mirfatif/SolarBMS/docs/current_voltage_module.jpg

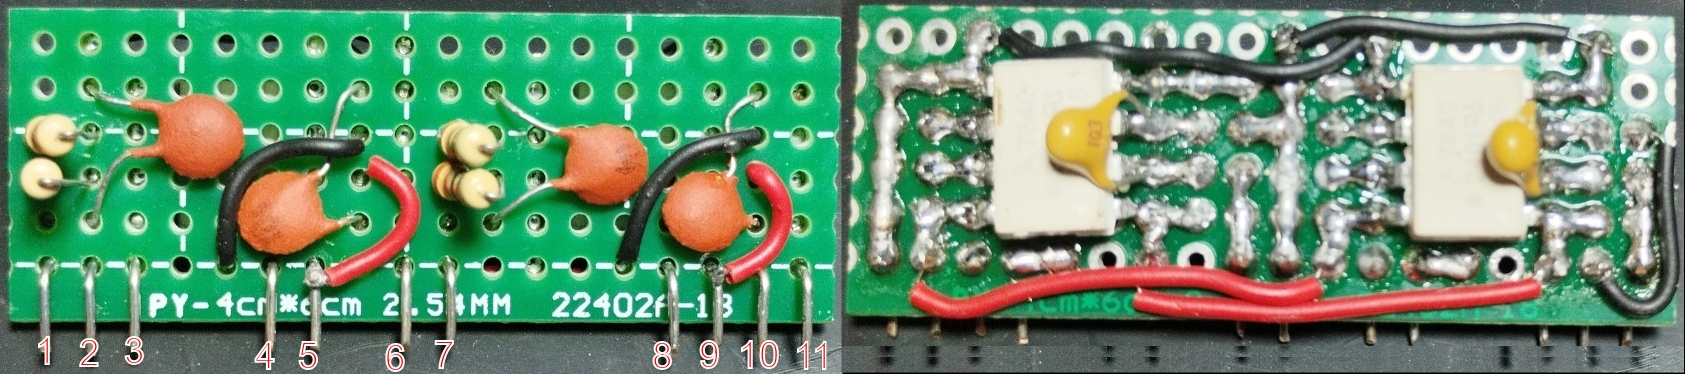
docs/current_voltage_module.jpg
