mirfatif/SolarBMS/docs/image.jpg

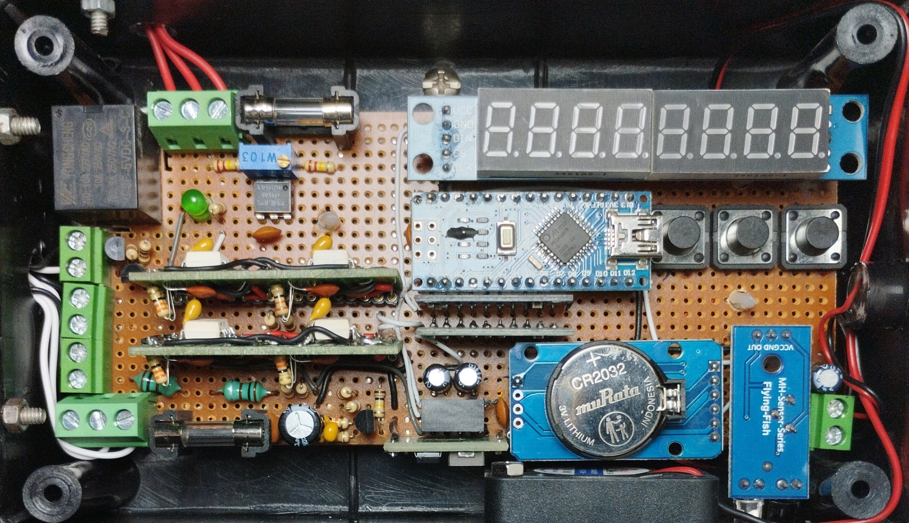
docs/image.jpg
