mirfatif/SolarBMS/README.md

## Solar and Battery Management System Using Arduino Nano

https://mirfatif.github.io/SolarBMS
