mirfatif/SolarBMS/docs/arduino_circuit.png

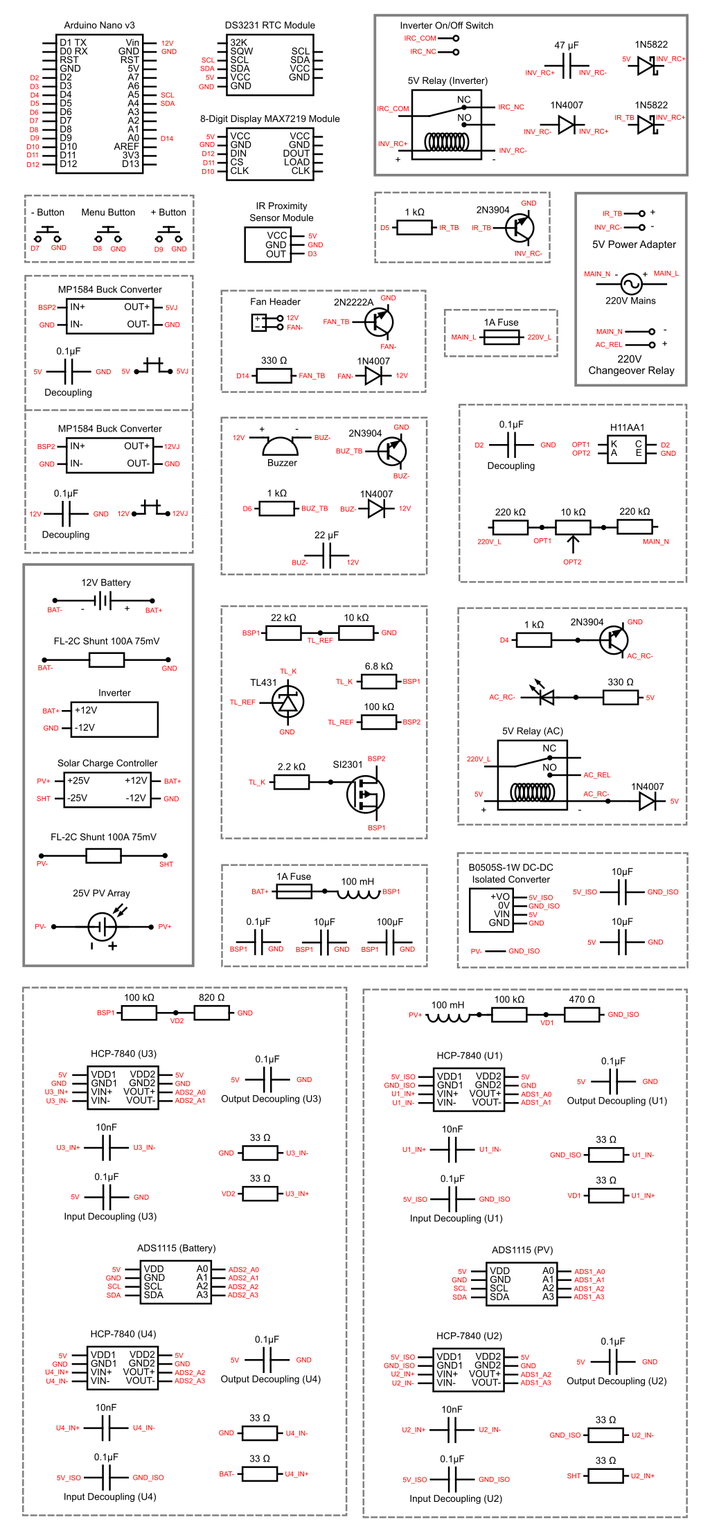
docs/arduino_circuit.png
