mirfatif/SolarBMS/docs/changeover_circuit.png

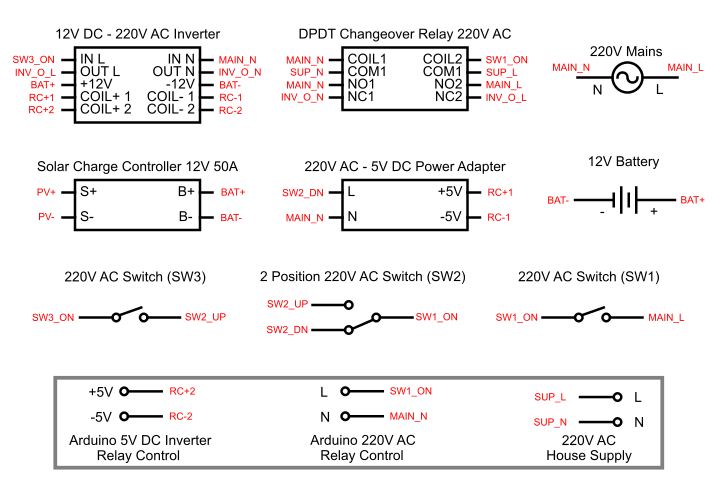
docs/changeover_circuit.png
