mirfatif/SolarBMS/docs/circuit_back.jpg

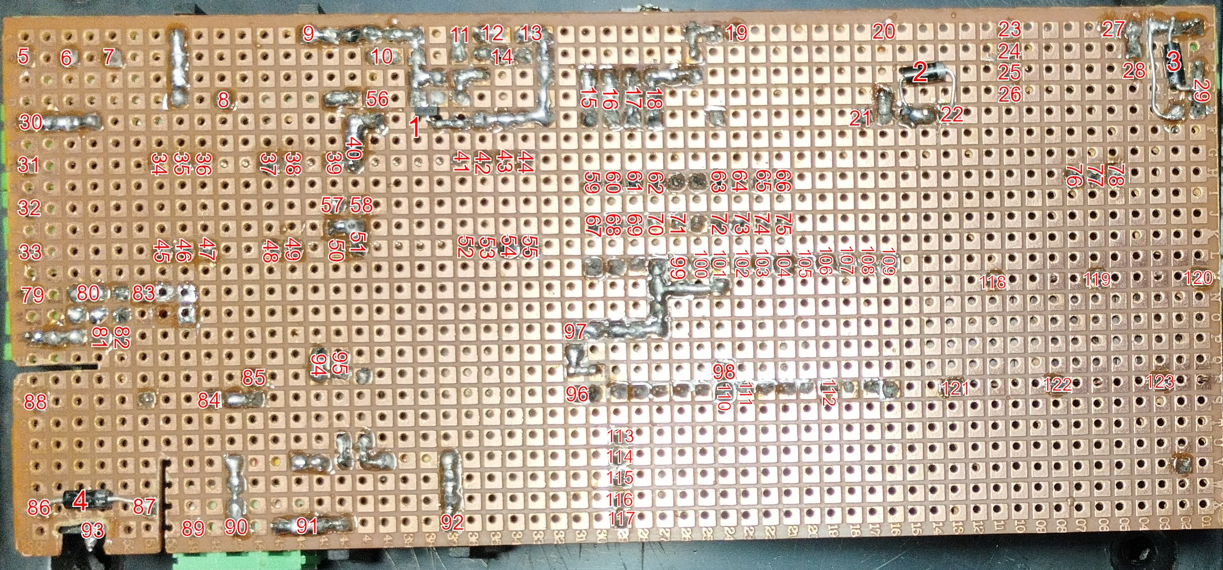
docs/circuit_back.jpg
