mirfatif/SolarBMS/docs/circuit_front.jpg

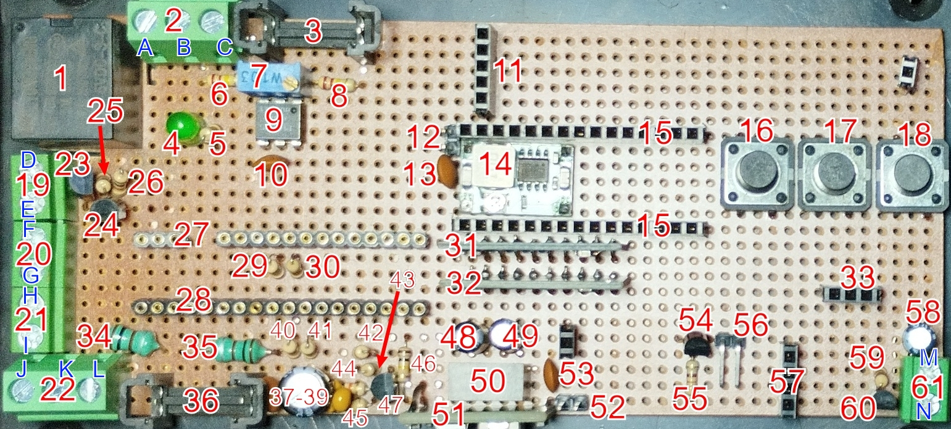
docs/circuit_front.jpg
