mirfatif/SolarBMS/docs/flowchart.png

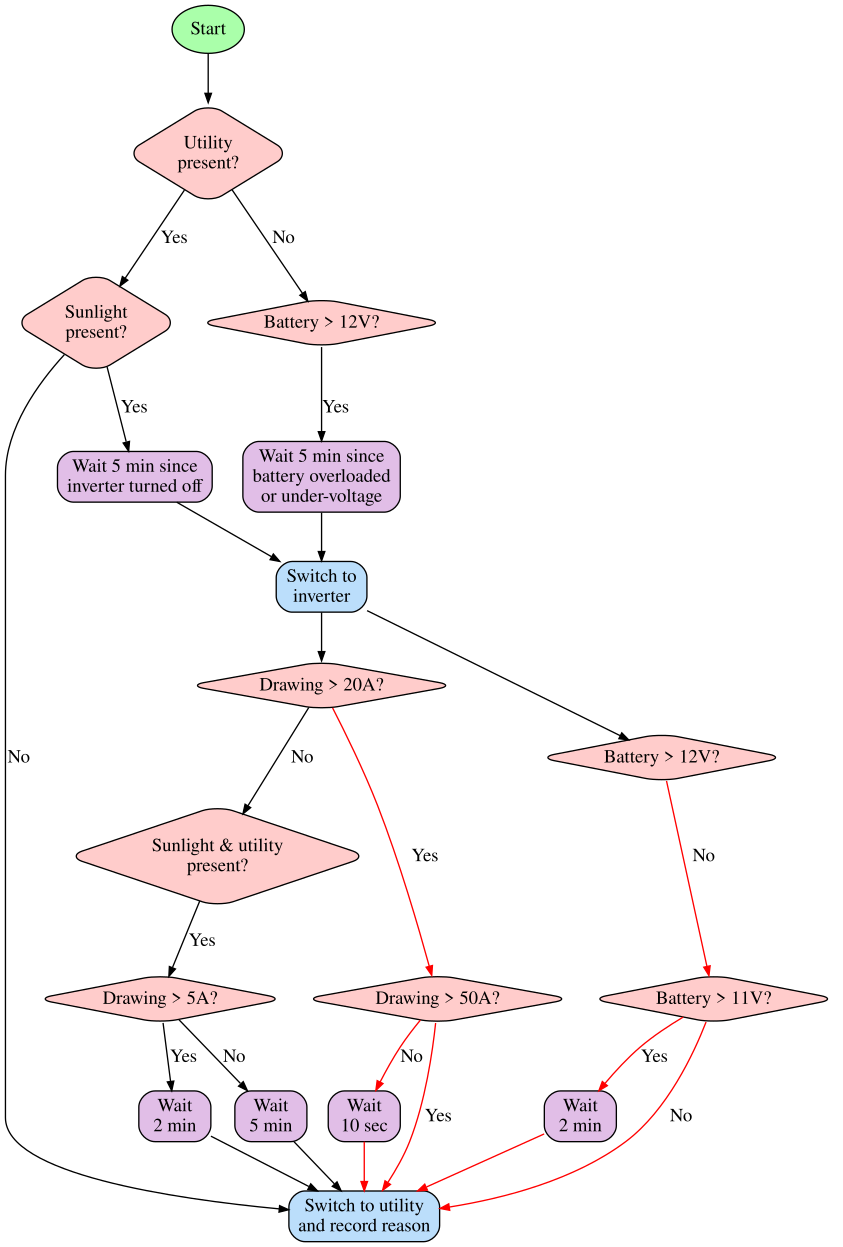
docs/flowchart.png
