mirfatif/SolarBMS/docs/Isolated I2C - 6N137.png

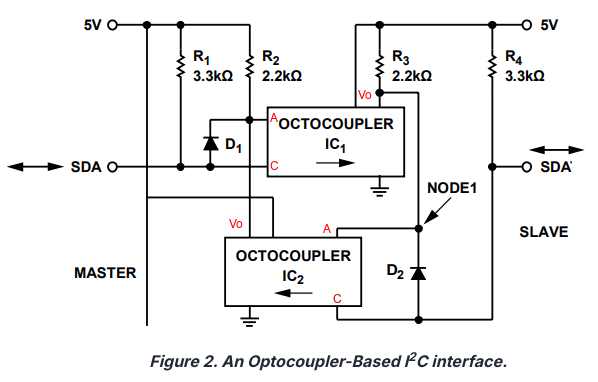
docs/Isolated I2C - 6N137.png
