mirfatif/SolarBMS/docs/Isolated INA219.png

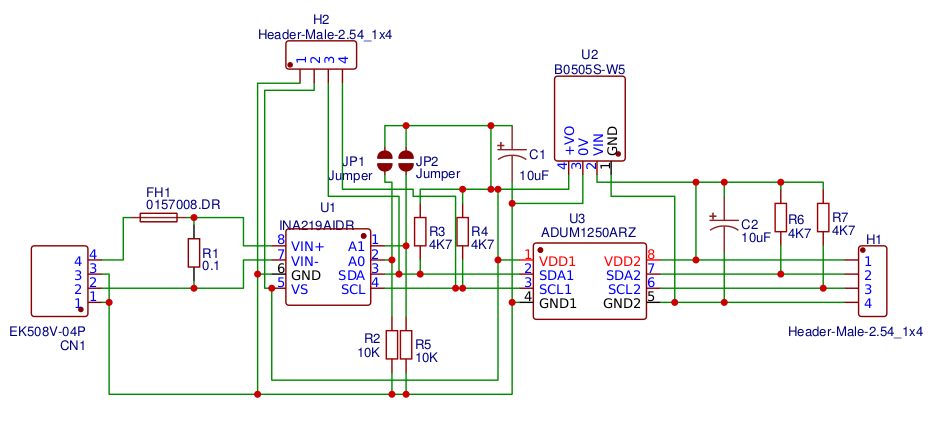
docs/Isolated INA219.png
