mirfatif/SolarBMS/(commit log)

2025-05-29 Fix solar check logic
    [SolarBMS.ino]
2025-05-29 Give inverter 5 seconds to start before switching from grid
2025-05-29 Fix short repeated alarms on battery voltage temporarily high and minor discharge during daytime
    [SolarBMS.ino]
2025-05-29 Fix high battery voltage offset by 0.04 when voltages are above 14
    [SolarBMS.ino]
2025-05-30 Fix changed prefs not loaded on start
    [SolarBMS.ino]
2025-05-30 Blink battery voltage and/or current values if not within safe limits
2025-05-30 Reduce buzzer on log
    [SolarBMS.ino]
2025-05-30 Blink bad battery voltage / current even when buzzer is waiting to start
    [SolarBMS.ino]
2025-05-30 More aggressively ignore temporary small battery discharge
2025-05-30 Add temperature screen at 3rd position
2025-06-01 Start beeping immediately if battery voltage go too high
    [SolarBMS.ino]
2025-06-01 Fix uint8_t and uint16_t not promoted to int before multiplication
    [SolarBMS.ino]
2025-06-01 Ignore low discharging during daytime if battery is above stable voltage
2025-06-05 Add pref to try switching to solar before solar-on time
2025-06-05 Fix issues due to millis() starting from 0 and wrapping every 49 days
    [SolarBMS.ino]
2025-06-05 Free up SRAM, we are running short
    [SolarBMS.ino]
2025-06-09 Give a 2 sec window to battery discharging @ >50A b4 switching to grid
2025-06-09 Consider battery low discharging only if voltages are below stable
2025-06-14 Remove unnecessary use of TimerOne
2025-06-14 Add pref: delay b4 switching to inverter after starting inverter
2025-06-16 Fix pre-solar time not working correctly
    [SolarBMS.ino]
2025-06-28 Add ATtiny85 + BH1750 rooftop sensor circuit
2025-06-28 Remove BH1750 light sensor use completely
2025-06-28 Remove unused H11AA1 Optocoupler details about AC voltage detection
2025-06-28 Remove battery voltage sensor desc and code; we use INA219
2025-06-28 Add desc for fuse heating due to skin effect
2025-06-28 MP2307 buck converter powers Nano; add description
2025-06-28 Add IR sensor description and code
2025-06-28 Waving hand b4 IR sensor rotates b/w informatory screens
2025-06-30 Do PV array current measurement to detect sunlight sufficiency
2025-06-30 Show screen number momentarily when switching to informatory screens
2025-06-30 Add PV array voltage, current screen
2025-07-01 Do longer delay if switched to grid due to sunlight not sufficient
2025-07-01 Add pref to set delay if switched to grid due to sunlight not sufficient
2025-07-03 Do not switch to solar if PV volts are low
2025-07-03 Replace 8-byte millis64() timestamp with 4-byte centis(), save SRAM
    [SolarBMS.ino]
2025-07-19 Do PV voltage / current sensation isolated
2025-07-20 Add cooling fan
2025-07-20 PV sensing: replace HCPL-7840 + CA3130 with INA219 + 4 x 6N137
    CA3130 gain is not constant (input <--> output relation is exponential, particularly at < ~150mV input.)
    [SolarBMS.ino]
2025-07-20 INA219 SCL pin is input-only, so we don't need bi-directional isolation
2025-07-20 PV sensing: Do I2C error check
    [SolarBMS.ino]
2025-07-21 PV sensing: Add UVLO for PV-powered circuit
2025-07-21 Add solar power screen
2025-07-22 Add current load calculation
2025-07-22 I2C isolation: Add feedback loop protection / SDA buffer
2025-07-24 I2C isolation: Simplify feedback loop protection
2025-07-24 Update flowchart
2025-07-24 Also add capacitor filers on shunt PV-side line
2025-07-27 Add fuses and HF noise filters
    [SolarBMS.ino]
2025-07-29 Update schematics
2025-07-29 I2C isolation: Replace LM78L05 with B0505S, 6N137 with ADuM1250
    [SolarBMS.ino]
2025-07-30 Use interrupt for IR sensor
2025-08-02 Add BoM
2025-08-03 Make IR sensor interrupt non-blocking
2025-08-03 Fix immediate jump to 1st screen from 5th info screen
    [SolarBMS.ino]
2025-08-03 Fix current/voltage sensors not initialized
    [SolarBMS.ino]
2025-08-08 Add SMD to DIP adapter in BoM
2025-08-11 Add Wire I2C timeout due to solar sensor
2025-08-13 Replace INA219 sensors with 2 x HCPL-7840 + ADS1115
    INA219 does high-side sensing. So is difficult to deal with HF noise coming from inverter and PWM charge controller.
    [SolarBMS.ino]
2025-08-13 Replace ZMPT101B with H11AA1 for simple grid AC detection
    [SolarBMS.ino]
2025-08-13 Replace AC changeover relay module with relay + BJT
    [SolarBMS.ino]
2025-08-14 Use bigger fan for cooling
2025-08-14 Add 7-8V UVLO with 12V battery supply
2025-08-14 Fix BoM mismatched quantities
2025-08-14 Fix H11AA1 ISR callback frequency
    [SolarBMS.ino]
2025-08-16 Update schematic
2025-08-17 Add green LED as mains ON indicator
2025-08-22 Fix 12V buck converter load calculation
2025-08-22 Fix cooling fan current draw
2026-05-21 Add circuit details and pictures
2026-05-22 Add battery/PV voltage/current calibration prefs
2026-06-01 Random fixes / improvements in code
    [SolarBMS.ino]
